tiagocriaar/AMBU-SOL-AR/README.md

# AMBU- SOL e AR
Projeto  para automação de AMBU

Equipe multidisciplinar une esforços no desenvolvimento de um equipamento que salvará muitas vidas de pacientes com Covid-19.
Respire conosco!

https://www.instagram.com/ambusolear/?igshid=74zuzm7dtrb
