tiagocriaar/AMBU-SOL-AR/Códigos Arduino/README.md

Links de Bibliotecas Arduino para  Controle de Motor de Passo 

SpeedyStepper - Arduino Library
https://github.com/Stan-Reifel/SpeedyStepper

FlexyStepper - Arduino Library
https://github.com/Stan-Reifel/FlexyStepper

AccelStepper library for Arduino
https://www.airspayce.com/mikem/arduino/AccelStepper/

Informações sobre o mecaninsmo do Eixo sem fim (Adão): 

Comprimento do eixo sem fim = 200 mm.    
Percurso para compressão do AMBU = 100 mm ou 130 mm.

FUSO 25 mm = 25 mm de avanço por volta.  
Para avançar os 100 mm são necessários 4 voltas no motor.  
Para avançar os 130 mm são necessários 5,2 voltas no motor.
