tiagocriaar/AMBU-SOL-AR/Documentação/Diagramas de circuitos/Ambu Sol e AR - Encoder rotativo.JPG

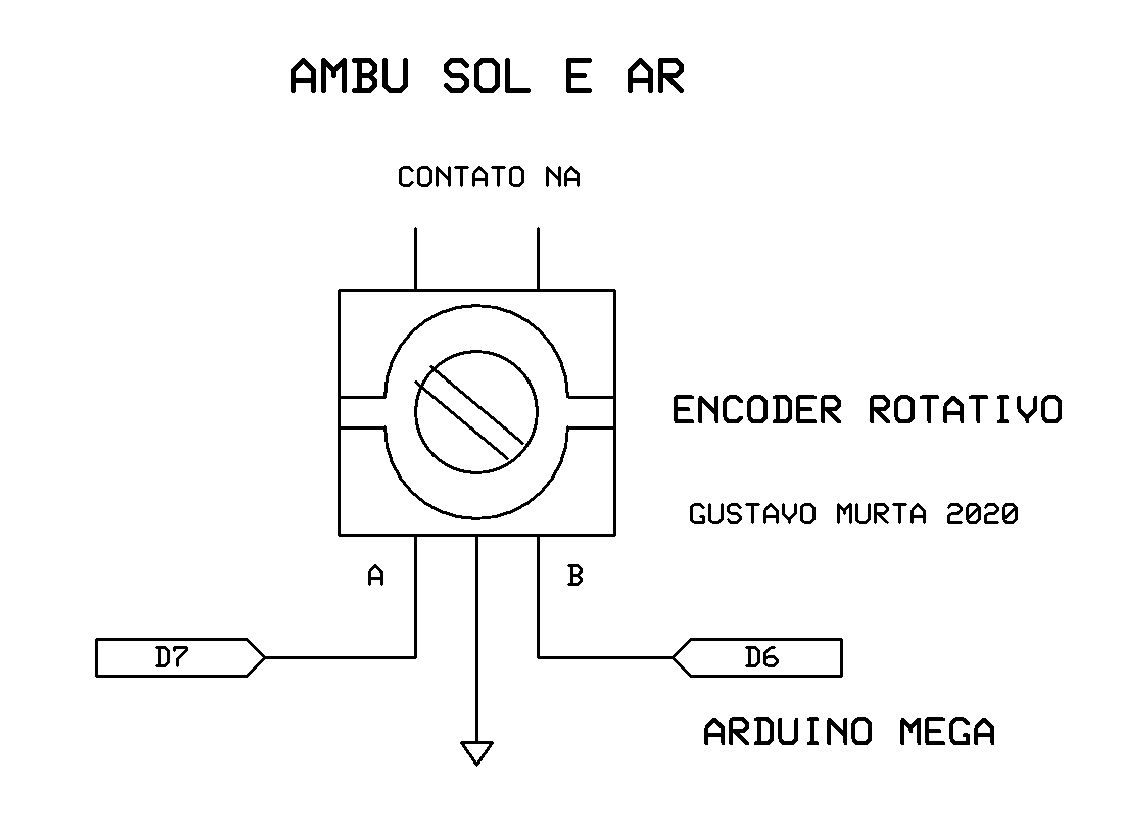
Documentação/Diagramas de circuitos/Ambu Sol e AR - Encoder rotativo.JPG
