tiagocriaar/AMBU-SOL-AR/Documentação/Diagramas de circuitos/Ambu Sol e AR - LCD 20x4 I2c.JPG

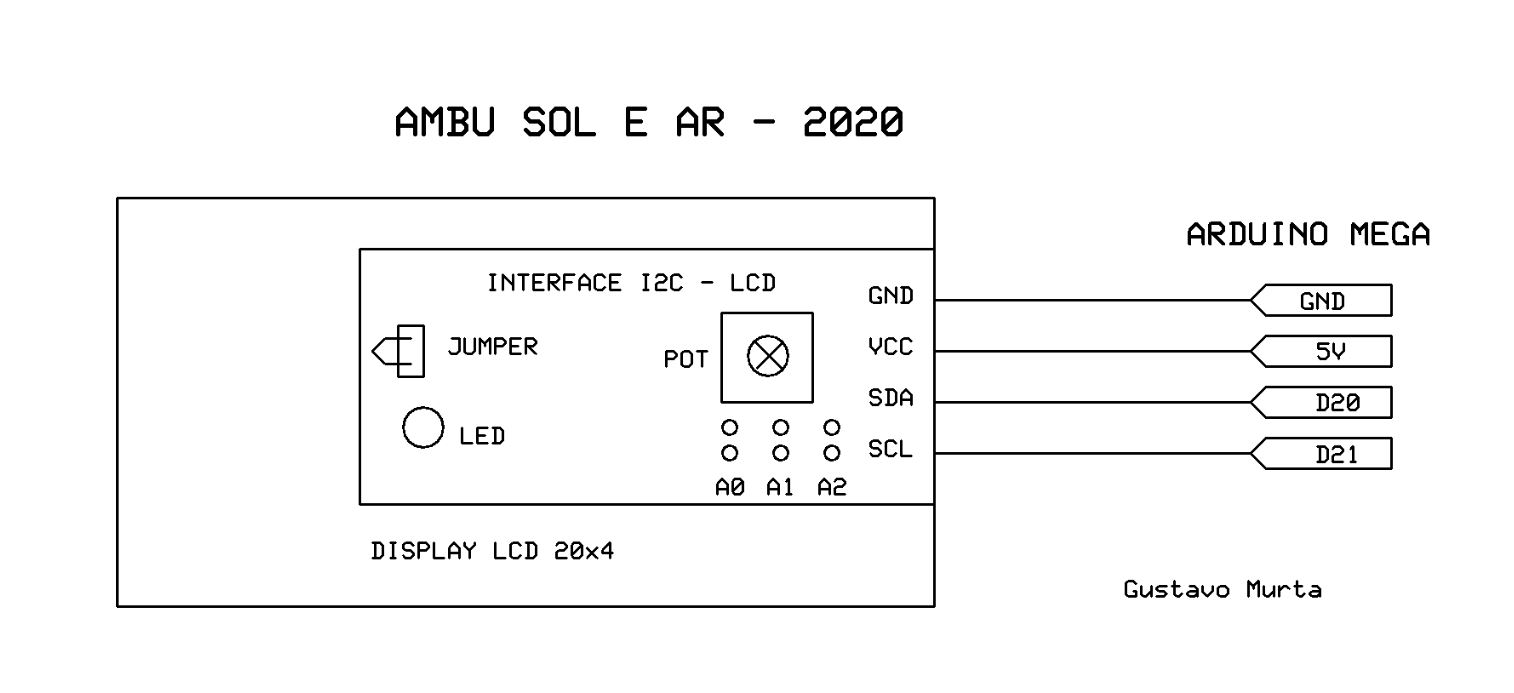
Documentação/Diagramas de circuitos/Ambu Sol e AR - LCD 20x4 I2c.JPG
