tiagocriaar/AMBU-SOL-AR/Documentação/Diagramas de circuitos/Encoder Rotativo Ambu.bmp

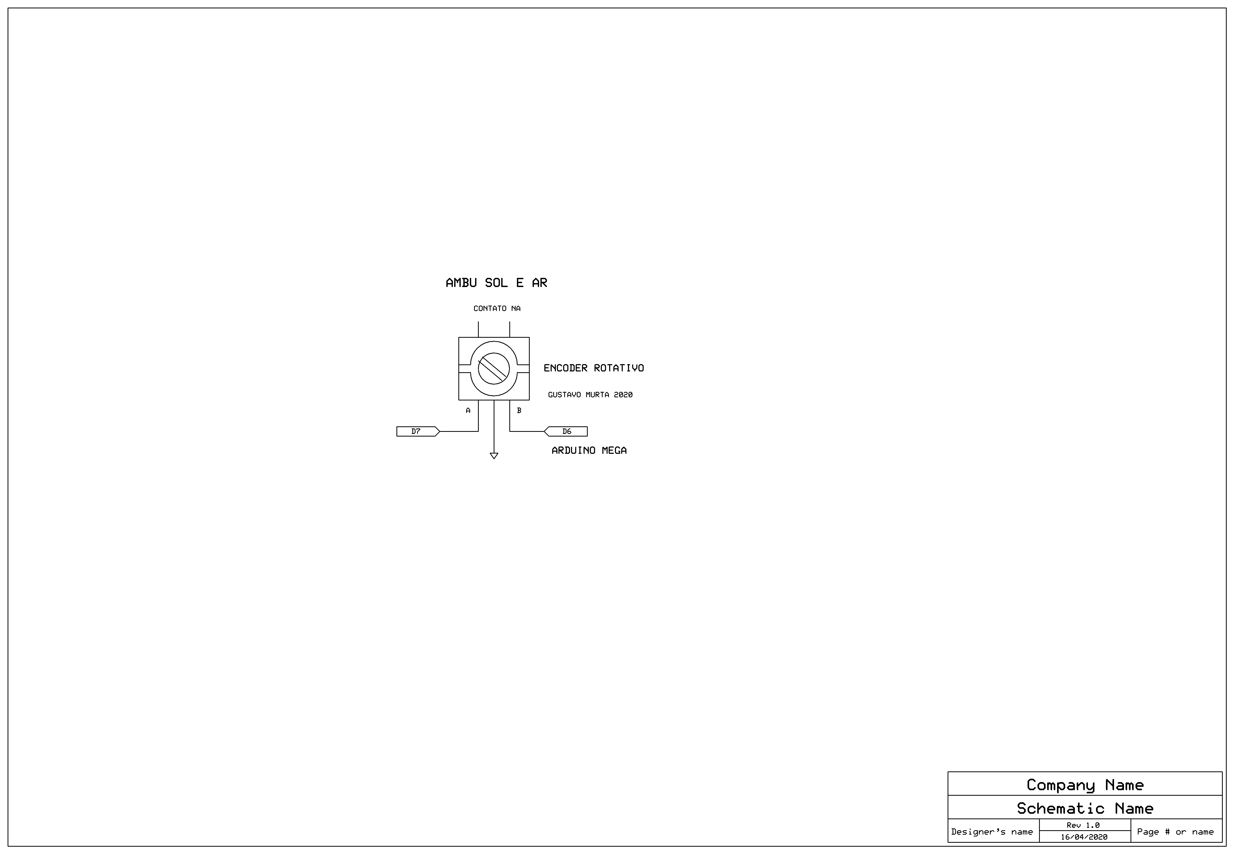
Documentação/Diagramas de circuitos/Encoder Rotativo Ambu.bmp
