tiagocriaar/AMBU-SOL-AR/Documentação/Diagramas de circuitos/Keypad 4X4 Ambu Sol e AR.JPG

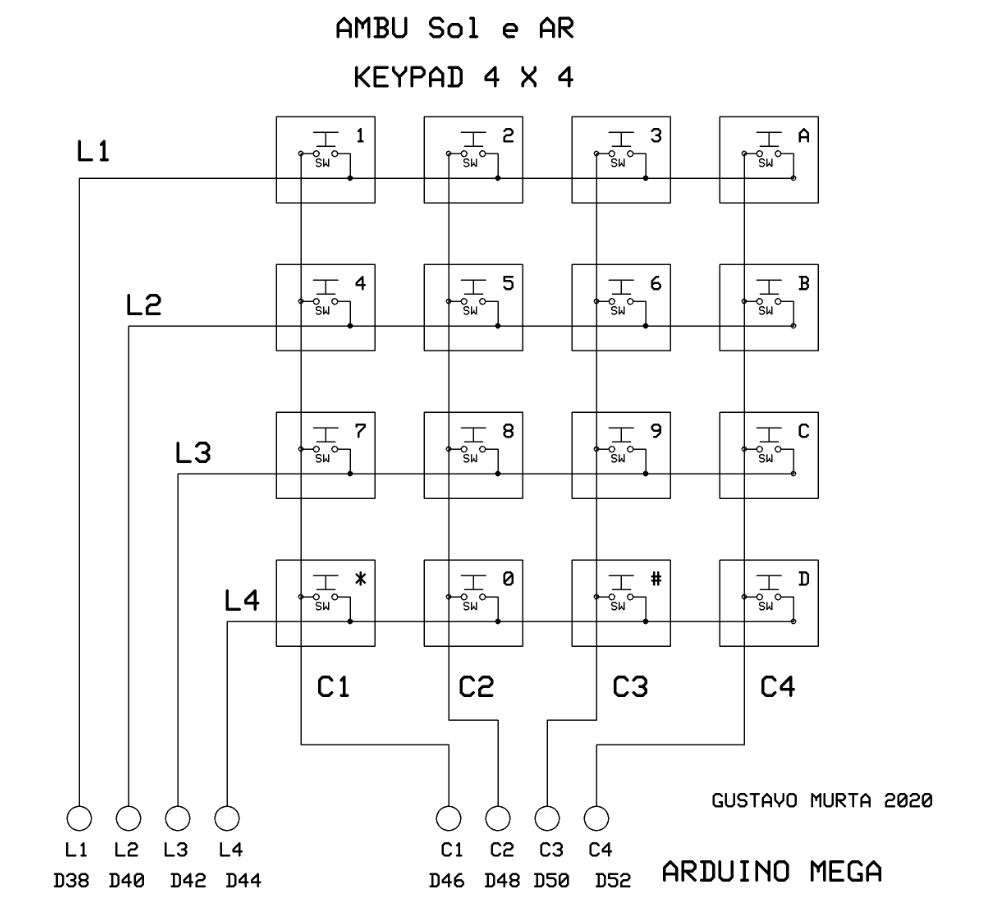
Documentação/Diagramas de circuitos/Keypad 4X4 Ambu Sol e AR.JPG
