tiagocriaar/AMBU-SOL-AR/Documentação/Projeto Mecânico/Auto Ambu 2.JPG

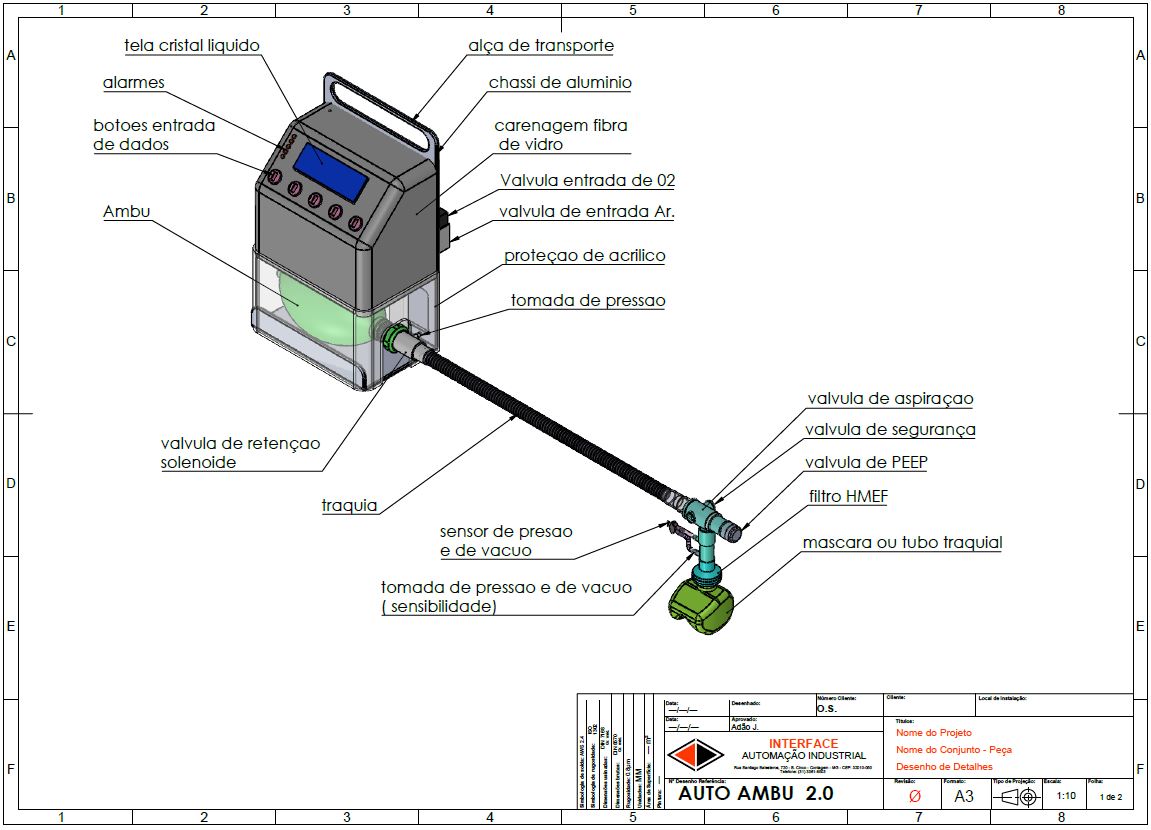
Documentação/Projeto Mecânico/Auto Ambu 2.JPG
