tiagocriaar/AMBU-SOL-AR/(threads)

Thread 7 (2020-05-18):

Controle do motor e medição de pressão

drelp7, 2020-05-18:
# A que parte do projeto esse Issue se refere?

- [X ] Software
- [ X] Hardware
- [ ] Dados
- [ ] Documentação
- [ ] Outro

Boa noite.

Gostaria de saber como vocês estão fazendo pra mover o motor e medir pressão ao mesmo tempo usando apenas um Arduino mega, o qual possui apenas um núcleo permitindo que apenas uma função seja executada e não 2 simultaneamente?

Vi que o ESP32 possui 2 núcleos e permite que 2 funções sejam executadas simultaneamente. Não seria melhor usá-lo ao invés do arduino mega?
