tiagocriaar/AMBU-SOL-AR/Códigos Arduino/SW_RESPIRADOR_SOL_AR_V1_40i/controle_MP.h

#ifndef _CONTROLE_MP_H_
#define _CONTROLE_MP_H_
#include "Arduino.h"

extern int enable_MP;
extern int dir_MP;

extern float percurso_Ambu;
extern int sentidoAmbu;
extern int velocidade_mm_por_seg; 
extern int indice_velocidade ;
extern int velocidade_respirador;

void calibracao_velocidade_motor ();              // Calibração de velocidade de INS - Tecla D
void procedimento_ligar();                        // Liga o motor
void procedimento_parar();                        // Para o fuso
void desativa_Driver_Motor();
void ativa_Driver_Motor();
#endif
