tiagocriaar/AMBU-SOL-AR/(commit log)

2020-04-05 Create Teoria de funcionamento
2020-04-05 Update Teoria de funcionamento
2020-04-06 Create Lista de material Eletrônico
2020-04-06 Update Lista de material Eletrônico
2020-04-06 Create Lista de Material
2020-04-06 Rename Lista de material Eletrônico to Lista de Material Eletrônico
2020-04-06 Rename Lista de Material to Lista de Material Mecânico
2020-04-06 Create Folhas de Especificações
2020-04-07 Create Display LCD 20x4 I2C
2020-04-08 Create Dicas de uso do Github
2020-05-15 Adicionando template de pull request no repositorio
2020-05-15 Adicionando template de Pull Request
